Wyatte73/ME-507-Mecha06/README.md

# ME-507-Mecha16 Ice Cold Beer Project

## Documentation

[View the Doxygen documentation](https://wyatte73.github.io/ME-507-Mecha06/)

## Table of Contents
- [Project Overview](#projectoverview)
- [Major Hardware](#major-hardware)
  - [PCB](#pcb)
  - [Mechanical Design](#mechanical-design)
  - [Stepper Motors](#stepper-motors)
  - [Distance Sensor](#distance-sensor)
  - [LCD](#lcd)
  - [Switches](#switches)
  - [Limit Switches](#limit-switches)
- [Software](#software)
  - [Main](#main)
  - [LCD Driver](#lcd-driver)
- [Problems and Solutions](#problems-and-solutions)
- [Moving Forward](#moving-forward)

## Project Overview
[Back to top](#Table-of-Contents)

This repository contains the ME-507 term project by Wyatt Eberhart and Max Soury. The goal of the project was to design, fabricate, and test a custom printed circuit board for an embedded control system based on the STM32F411CE6U microcontroller.

The project was inspired by the classic Ice Cold Beer arcade game, where the player controls a bar to guide a ball upward while avoiding holes. In this version, the system uses two stepper motors to control the motion of the bar, allowing the user to adjust each side independently. A distance sensor, two limit switches, two user switches, and an LCD display were integrated into the system to allow for a control system and a user controlled mode.

The custom PCB served as the central hardware interface for the project. It connected the STM32 microcontroller to the motors, sensors, switches, and display, creating a clean and viable control platform. The STM32 reads the user switches and sensor inputs, processes the game-control logic, and commands the stepper motors to move the bar accordingly.

Overall, this project demonstrates the development of a complete embedded mechatronic system, combining PCB design, microcontroller programming, stepper motor control, sensor integration, and a user-interface to recreate a game. Figure 1 shows the game being replicated.

<p align="center">
  R
</p>
<p align="center">
  Figure 1. Ice Cold Beer Game
</p>

## Major Hardware
[Back to top](#Table-of-Contents)

### PCB

The PCB was based on the STM32 Blackpill, with additional features added to support motor control, display adjustment, and power regulation. The Blackpill reference design provided the basic circuitry required to operate the STM32F411CEU6, including reset, BOOT0, and Serial Wire Debugging connections. The PCB schematic is shown in Figure 2-3. The final PCB is shown in Figure 4 and the necessary components are shown in Figure 5.

Additional components were added to expand the board’s functionality. An 8 MHz crystal was included to provide more precise timing for the microcontroller. An LCD potentiometer was added to allow manual adjustment of the LCD brightness. For stepper motor control, two TMC2209 motor drivers and two TMC4210 motor controllers were included. The crystal is shown in Figure 5.

The TMC2209 motor drivers were used to drive the stepper motors. These ICs receive step and direction logic signals and generate the appropriate output signals for the motor coils. The step and direction signals are generated by the TMC4210 motor controllers, which communicate with the STM32 microcontroller over SPI. The TMC4210 uses motion parameters such as position, velocity, acceleration, and operating mode to generate the required step and direction outputs for each motor. The motor controllers and motor drivers are shown in Figure 6-7. 

The board was powered using a 12 V wall adapter. A buck converter, the LM2576, stepped the input voltage down from 12 V to 5 V, creating the 5 V power rail. An AMS1117 low-dropout linear regulator then reduced the 5 V rail to 3.3 V, which was used to power the STM32 microcontroller and other 3.3 V components. The power management system also included reverse-current protection to prevent current from flowing back into the wall adapter. The power system is shown in Figure 8-9.

<p align="center">
  
  
</p>
<p align="center">
  Figure 2-3. PCB Schematic
</p>

<p align="center">
  <img width="3024" height="4032"" alt="IMG_7492" src="https://github.com/user-attachments/assets/e71a02a3-5c6f-4b3f-9c1d-4fd526b5dee1" />
</p>
<p align="center">
  Figure 4. Final PCB
</p>
<p align="center">
  
</p>
<p align="center">
  Figure 5. Necessary components for the STM32
</p>
<p align="center">
  
</p>
<p align="center">
  Figure 6. Stepper motor controller and drivers
</p>
<p align="center">
 
</p>
<p align="center">
  Figure 7. Destroyed motor controller and alterned power input for motor controller
</p>
<p align="center">
  IMG_7495 (1)
</p>
<p align="center">
  Figure 8. Power management system
</p>
<p align="center">
 
</p>
<p align="center">
  Figure 9. LDO fix to remove thermal heat
</p>

### Mechanical Design
[Back to top](#Table-of-Contents)

The mechanical design uses two independently controlled lift assemblies located on opposite sides of the game board. This design works similarly to the mechanism used in the Ice Cold Beer arcade game, where each side of the support bar can move up and down independently to control the tilt of the playing surface or guide mechanism.

Each side of the mechanism is driven by a stepper motor connected to a lead screw. As the stepper motor rotates the lead screw, a lead screw nut converts the rotational motion into linear motion, causing the carriage to move vertically. This allows each side of the board mechanism to be raised or lowered independently.

Guide rods are used to constrain the carriage so that it moves only in the vertical direction. These rods prevent the carriage from twisting or rotating as the lead screw turns. The center rod is supported in a way that allows it to rotate freely while still maintaining proper alignment. One end of the rod is fixed axially and only allowed to rotate, while the opposite end is allowed to both rotate and slide. This prevents the assembly from being over-constrained and helps account for small alignment errors during motion.

Overall, the system uses two stepper-driven lead screw assemblies to control the vertical position of each side of the mechanism. By moving the two sides independently, the system can adjust the angle of the board or guide bar, allowing controlled movement of the ball during gameplay.

The other components are static and to structurally hold the assembly together. A CAD model of the system is shown in Figure 10. The overall system is shown in Figure 11. The lift assembly and sliding are shown in Figure 12. The fixed joint that holds the linear sensor is shown in Figure 13. 

<p align="center">

</p>
<p align="center">
  Figure 10. CAD model of the system
</p>
<p align="center">
 
</p>
<p align="center">
  Figure 11. Physical system
</p>
<p align="center">

</p>
<p align="center">
  Figure 12. Lift assembly and sliding joint
</p>
<p align="center">
  
</p>
<p align="center">
  Figure 13. Fixed joint with the linear sensor
</p>

### Stepper Motors
[Back to top](#Table-of-Contents)

The system uses 42BYGHM809 stepper motors to drive the vertical motion assemblies on each side of the game board. These motors were selected because they provide precise position control, which is necessary for accurately raising and lowering each side of the mechanism. These steppers have 400 steps/rev which allowed for greater precision and smoother rotation (less notchy). The stepper motor is shown in Figure 14.

<p align="center">
  
</p>
<p align="center">
  Figure 14. Stepper motor
</p>

### Distance Sensor
[Back to top](#Table-of-Contents)

A Pololu Distance Sensor V2 with pulse width output and a maximum sensing range of 50 cm, item 5562, was used to measure the position of the ball on the game board. The sensor outputs a pulse width signal that corresponds to the measured distance, allowing the microcontroller to determine how far the ball is from the sensor. This distance measurement can then be used as feedback for tracking the ball’s position during gameplay. The distance sensor is shown in Figure 15.

<p align="center">
  
</p>
<p align="center">
  Figure 15. Distance sensor
</p>

### LCD
[Back to top](#Table-of-Contents)

A generic LCD module was added for user information. Either to display the current estimated position of the ball, in control mode. Or to display a time for scorekeeping in the user control mode. The LCD is driven by an on board controller that uses the Hitachi LCD interfacing protocol. Because of an abundacne of MCU GPIO ports the LCD was driven directly using the 11 pin control scheme, and a shift register was not included for simplicity. The LCD is shown in FIgure 16.

<p align="center">
  
</p>
<p align="center">
  Figure 16. LCD
</p>

### Switches
[Back to top](#Table-of-Contents)

Rocker switches were used as user input controls for the system. These switches provide a simple and reliable way for the user to control the motors up or down. Since they are single-pole double-throw switches, each switch can route a signal between two different states or positions.

<p align="center">
  
</p>
<p align="center">
  Figure 17. Rocker switch
</p>

### Limit Switches
[Back to top](#Table-of-Contents)

Limit switches were used to detect the end positions of the moving carriages. These switches help prevent the mechanism from traveling beyond its intended range. When a carriage reaches a limit switch, the switch sends a signal to the TMS4210 motor controller. This allows the software to stop or home the motor, protecting the mechanical system from overtravel or damage. The limit switch is shown in Figure 18.

<p align="center">
  
</p>
<p align="center">
  Figure 18. Limit switch 
</p>

## Software
[Back to top](#Table-of-Contents)

### Main

This holds the initialization code for the motor controllers and handles the distance sensor readings via an interupt on the timer channel it is connected to. This interupt function tracks the amount of clock ticks between the high and low pulses from the disance sensor's pwm output and then converts it to a distance in inches based on a linear curve fit. It then displays this distance data on the LCD screen, updated less frequently than the actual distance value.

### LCD Driver
[Back to top](#Table-of-Contents)

This library takes the basic commands of the Hitachi protocol LCD driver and allows the display to be cleared, the location of the cursor moved, or to write a single ascii character to the display. This library ensures the lcd has had enough time to update before sending commands, and due to limitations discussed later only sends write commands to the board.

### Problems and Solutions
[Back to top](#Table-of-Contents)

On the power side of the board, there were a few surpassable issues. Firstly, the thermal pin on the LDO to move from 5V to 3V3 is wired to ground on the board and internally connected to the output. The capacitor attached to the output of the switching regulator was designed around a size of capacitor that does not come in the intended package. And the diode connected to the reverse current protection circut did not have through holes large enough to mount properly.

All of these problems were able to be worked around. After destroying a handfull of regulators the source of the problem was found and the chip was stood up such that the thermal pin was floating and some extra wire was added to act as a heatsink. Some jumper wires were added to the pads designated for the mis-sized capacitor and the capacitor was added to these wires. And the leads for the diode were clipped to a reasonable length and soldered on top of the though holes. The power side of the board remained stable after these changes.

The LCD had a few problems that needed fixing. The enable pin and the contrast voltage pin were both pulled to 5V which caused the board to not be able to recieve commands, but also for the characters on the screen to not be visible. This was solved by sacrificing the R/W pin on the connector and transforming it into the enable pin, this tied the R/W signal to ground and removed the ablilty to read from our display but allowed for commands in general to be sent. And to fix the contrast issue a resistor was added to the contrast voltage pin, normally a potentiometer is added in this place to fine tune the contrast on the display but as this was a hot fix the ability to ajust contrast was forgone and manually set to an accpetable level.

The largest problems came unfortunately in the most important part of out design, being our motors, The main problem was the chips were designed in 5V operating mode, while the MCU uses 3V3 logic. This caused some issues with SPI communication so pins on the motoin control chips were bent and ajusted to work on 3V3 by tying them to the test points on the board. This sucessfully enabled communication with the chips and allowed for velocites to be sent to the stepper motors. 

A much larger setback was during testing and diagnosis of the logic voltage issue, one of the motion controllers was removed from the board to simplify testing, however its matching motor driver was left on the board and, lacking the current regulation from the controller, was catastrophically destroyed under the amperage of the power supply. This was an unrecoverable event and is the reason most of the functionallity of our system is not present. 

The pivoted idea was to just have the distance sensor controll the motor in 1D and balance the ball in the center of the shaft, but during implementation the second motor controller stopped responding. So in its current state the device reads a distace value and displays it on the LCD.

### Moving Forward
[Back to top](#Table-of-Contents)

We Both are very sadened to have this be the outcome of the project, but we both feel extremely confidant in a V2 of the system if were to have permitted it. It is almost certian that a second version of the PCB would still not be perfect, but with our newfound understanding it would be a significant improvment on the first rendition, and would have allowed us to begin to tackle the chalenge of controling the system. Becides the re-assigning of pins and resizing of components, a more more enlightened outlook would be taken when selecting the motor control and driving ICs and could be swapped to a DC motor and encoder setup to simplify the control hardware, while increasing the software load.
