Wyatte73/ME-507-Mecha06/ICB/Core/Src/main.c

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
/* Includes ------------------------------------------------------------------*/
#include "main.h"

/* USER CODE BEGIN Includes */
#include "LCD.h"
#include <math.h>
#include <stdio.h>
/* USER CODE END Includes */

SPI_HandleTypeDef hspi2;

TIM_HandleTypeDef htim2;
TIM_HandleTypeDef htim4;

/* USER CODE BEGIN PV */
uint8_t en_sd[4] = {0x34, 0x00, 0x00, 0x01};
uint8_t V_MIN[4]    = {0b00000100, 0b00000000, 0b00000000, 0b00000100};
uint8_t V_MAX[4]    = {0b00000110, 0b00000000, 0b00000000, 0b10000000};
uint8_t PR_DIV[4]   = {0b00011000, 0b00000000, 0b00100010, 0b00000000};
uint8_t A_MAX[4]    = {0b00001100, 0b00000000, 0b00000000, 0b00100000};
uint8_t V_TAR[4] = {0b00001000,0b00000000,0b00000000,0b00100000};
uint8_t ref_con[4] = {0b00010100,0b00000000,0b00000011,0b00000010};

// +128
uint8_t V_TARU_1[2] = {0b00001000, 0b00000000};
uint8_t V_TARU_2[2] = {0b00000000, 0b10000000};

// -128
uint8_t V_TARD_1[2] = {0b00001000, 0b00000000};
uint8_t V_TARD_2[2] = {0b00001111, 0b10000000};


uint8_t V_ACT_1[4] = {0b00001001,0b00000000,0b00000000,0b00000000};
uint8_t V_ACT_R[4];

uint8_t V_old;
uint8_t count = 0;

uint8_t dir = 0;

LCD_param_t LCD = {RS_GPIO_Port,RS_Pin,EN_GPIO_Port,EN_Pin,RW_GPIO_Port,RW_Pin,DB0_GPIO_Port,DB0_Pin,
		DB1_GPIO_Port,DB1_Pin,DB2_GPIO_Port,DB2_Pin,DB3_GPIO_Port,DB3_Pin,DB4_GPIO_Port,DB4_Pin,
		DB5_GPIO_Port,DB5_Pin,DB6_GPIO_Port,DB6_Pin,DB7_GPIO_Port,DB7_Pin};

char digs[5];


uint8_t test;

uint32_t loop = 0;

volatile uint32_t val1 = 0;
volatile uint32_t val2 = 0;
volatile uint32_t pulse_width = 0;
volatile uint8_t is_rising_edge = 1;
float pulse_raw;

/* USER CODE END PV */

void SystemClock_Config(void);
static void MX_GPIO_Init(void);
static void MX_SPI2_Init(void);
static void MX_TIM4_Init(void);
static void MX_TIM2_Init(void);
/**
  * @brief  The application entry point.
  * @retval int
  */
int main(void)
{

  /* MCU Configuration--------------------------------------------------------*/

  /* Reset of all peripherals, Initializes the Flash interface and the Systick. */
  HAL_Init();

  /* Configure the system clock */
  SystemClock_Config();

  /* Initialize all configured peripherals */
  MX_GPIO_Init();
  MX_SPI2_Init();
  MX_TIM4_Init();
  MX_TIM2_Init();
  /* USER CODE BEGIN 2 */

  HAL_TIM_PWM_Start(&htim4, TIM_CHANNEL_4);



  /* Set V_MIN */
  HAL_GPIO_WritePin(nCs2_GPIO_Port,nCs2_Pin,GPIO_PIN_RESET);
  HAL_SPI_Transmit(&hspi2,V_MIN,4,1);
  HAL_GPIO_WritePin(nCs2_GPIO_Port,nCs2_Pin,GPIO_PIN_SET);

  /* Set V_MAX */
  HAL_GPIO_WritePin(nCs2_GPIO_Port,nCs2_Pin,GPIO_PIN_RESET);
  HAL_SPI_Transmit(&hspi2,V_MAX,4,1);
  HAL_GPIO_WritePin(nCs2_GPIO_Port,nCs2_Pin,GPIO_PIN_SET);

  /* Set PULSE_DIV / RAMP_DIV */
  HAL_GPIO_WritePin(nCs2_GPIO_Port,nCs2_Pin,GPIO_PIN_RESET);
  HAL_SPI_Transmit(&hspi2,PR_DIV,4,1);
  HAL_GPIO_WritePin(nCs2_GPIO_Port,nCs2_Pin,GPIO_PIN_SET);

  /* Set A_MAX */
  HAL_GPIO_WritePin(nCs2_GPIO_Port,nCs2_Pin,GPIO_PIN_RESET);
  HAL_SPI_Transmit(&hspi2,A_MAX,4,1);
  HAL_GPIO_WritePin(nCs2_GPIO_Port,nCs2_Pin,GPIO_PIN_SET);

  /* Set reference switch configuration and velocity mode */
  HAL_GPIO_WritePin(nCs2_GPIO_Port,nCs2_Pin,GPIO_PIN_RESET);
  HAL_SPI_Transmit(&hspi2,ref_con,4,1);
  HAL_GPIO_WritePin(nCs2_GPIO_Port,nCs2_Pin,GPIO_PIN_SET);

  /* Enable Step/Dir output */
  HAL_GPIO_WritePin(nCs2_GPIO_Port,nCs2_Pin,GPIO_PIN_RESET);
  HAL_SPI_Transmit(&hspi2,en_sd,4,1);
  HAL_GPIO_WritePin(nCs2_GPIO_Port,nCs2_Pin,GPIO_PIN_SET);

  /* Set V_TARGET */
  /*
  HAL_GPIO_WritePin(nCs2_GPIO_Port,nCs2_Pin,GPIO_PIN_RESET);
  HAL_SPI_Transmit(&hspi2,V_TAR_1,2,1);
  HAL_SPI_Transmit(&hspi2,V_TAR_2,2,1);
  HAL_GPIO_WritePin(nCs2_GPIO_Port,nCs2_Pin,GPIO_PIN_SET);
  */

HAL_GPIO_WritePin(RW_GPIO_Port,RW_Pin,GPIO_PIN_SET);


  Init(LCD);
  ClearDis(LCD);
  PutChar(LCD,'D');
  PutChar(LCD,'I');
  PutChar(LCD,'S');
  PutChar(LCD,'T');
  PutChar(LCD,'A');
  PutChar(LCD,'N');
  PutChar(LCD,'C');
  PutChar(LCD,'E');
  PutChar(LCD,':');
  PutChar(LCD,'0');
  PutChar(LCD,'0');
  PutChar(LCD,'.');
  PutChar(LCD,'0');
  PutChar(LCD,'0');
  PutChar(LCD,'i');
  PutChar(LCD,'n');
  while (count < 7) {ShiftCursor(LCD,'L'); count++;}
  count = 0;

  HAL_TIM_IC_Start_IT(&htim2, TIM_CHANNEL_1);
  /* USER CODE END 2 */

  /* Infinite loop */
  /* USER CODE BEGIN WHILE */
  while (1)
  {
	  pulse_raw = pulse_width * .0003 - 29;


	  int16_t velocity = (int16_t)(roundf(pulse_raw) * 10);
	  // Clamp to 12-bit signed range [-2047, 2047]
	  if (velocity >  2047) velocity =  2047;
	  if (velocity < -2047) velocity = -2047;

	  V_TAR[1] = 0x00;
	  V_TAR[2] = (velocity >> 8) & 0x0F;
	  V_TAR[3] = (uint8_t)(velocity & 0xFF);

	  if (V_TAR[3] != V_old){
	  HAL_GPIO_WritePin(nCs2_GPIO_Port,nCs2_Pin,GPIO_PIN_RESET);
	  HAL_SPI_Transmit(&hspi2,V_TAR,4,1);
	  HAL_GPIO_WritePin(nCs2_GPIO_Port,nCs2_Pin,GPIO_PIN_SET);
	  V_old = V_TAR[3];
	  }


	  if (loop % 10000 == 0){
		  test = (uint8_t)roundf(pulse_raw*100);
		  if(pulse_raw<1){
			  snprintf(digs,sizeof(digs),"%d",(int)roundf(pulse_raw * 100));
			  PutChar(LCD,'0');
			  PutChar(LCD,'0');
			  ShiftCursor(LCD,'R');
			  PutChar(LCD,digs[0]);
			  PutChar(LCD,digs[1]);
		  		  }
		  else if(pulse_raw<10){
		  	  snprintf(digs,sizeof(digs),"%d",(int)roundf(pulse_raw * 100));
		  	  PutChar(LCD,'0');
		  	  PutChar(LCD,digs[0]);
		  	  ShiftCursor(LCD,'R');
		  	  PutChar(LCD,digs[1]);
		  	  PutChar(LCD,digs[2]);
		  }

		  else{
			  snprintf(digs,5,"%d",(int)roundf(pulse_raw * 100));
			  PutChar(LCD,digs[0]);
			  PutChar(LCD,digs[1]);
			  ShiftCursor(LCD,'R');
			  PutChar(LCD,digs[2]);
			  PutChar(LCD,digs[3]);
		  }
		  	  while (count < 5) {ShiftCursor(LCD,'L'); count++;}
		  	  count=0;
	  }
	  loop++;

    /* USER CODE END WHILE */

    /* USER CODE BEGIN 3 */
  }
  /* USER CODE END 3 */
}

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
/* USER CODE BEGIN 4 */

void HAL_TIM_IC_CaptureCallback(TIM_HandleTypeDef *htim)
{
    if (htim->Instance != TIM2) return;  // Guard: only handle TIM2

    if (is_rising_edge) {
        // Capture rising edge timestamp
        val1 = HAL_TIM_ReadCapturedValue(htim, TIM_CHANNEL_1);

        // Switch to falling edge
        __HAL_TIM_SET_CAPTUREPOLARITY(htim, TIM_CHANNEL_1,
                                      TIM_INPUTCHANNELPOLARITY_FALLING);
        is_rising_edge = 0;

    } else {
        // Capture falling edge timestamp
        val2 = HAL_TIM_ReadCapturedValue(htim, TIM_CHANNEL_1);

        // Handle 32-bit timer overflow correctly
        if (val2 >= val1) {
            pulse_width = val2 - val1;
        } else {
            pulse_width = (0xFFFFFFFF - val1) + val2 + 1;
        }

        // Switch back to rising edge for next pulse
        __HAL_TIM_SET_CAPTUREPOLARITY(htim, TIM_CHANNEL_1,
                                      TIM_INPUTCHANNELPOLARITY_RISING);
        is_rising_edge = 1;
    }
}

/* USER CODE END 4 */
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
