Wyatte73/ME-507-Mecha06/ICB/Core/Inc/main.h

#define OUT_Pin GPIO_PIN_0
#define OUT_GPIO_Port GPIOA
#define RS_Pin GPIO_PIN_1
#define RS_GPIO_Port GPIOA
#define RW_Pin GPIO_PIN_2
#define RW_GPIO_Port GPIOA
#define DB0_Pin GPIO_PIN_3
#define DB0_GPIO_Port GPIOA
#define DB1_Pin GPIO_PIN_4
#define DB1_GPIO_Port GPIOA
#define DB2_Pin GPIO_PIN_5
#define DB2_GPIO_Port GPIOA
#define DB3_Pin GPIO_PIN_6
#define DB3_GPIO_Port GPIOA
#define DB4_Pin GPIO_PIN_7
#define DB4_GPIO_Port GPIOA
#define DB5_Pin GPIO_PIN_0
#define DB5_GPIO_Port GPIOB
#define DB6_Pin GPIO_PIN_1
#define DB6_GPIO_Port GPIOB
#define DB7_Pin GPIO_PIN_2
#define DB7_GPIO_Port GPIOB
#define EN_Pin GPIO_PIN_12
#define EN_GPIO_Port GPIOB
#define nCs2_Pin GPIO_PIN_13
#define nCs2_GPIO_Port GPIOB
#define LED_Pin GPIO_PIN_8
#define LED_GPIO_Port GPIOA
#define DN2_Pin GPIO_PIN_4
#define DN2_GPIO_Port GPIOB
#define UP2_Pin GPIO_PIN_5
#define UP2_GPIO_Port GPIOB
#define DN1_Pin GPIO_PIN_6
#define DN1_GPIO_Port GPIOB
#define UP1_Pin GPIO_PIN_7
#define UP1_GPIO_Port GPIOB
