Wyatte73/ME-507-Mecha06/(commit log)

2026-06-11 Update PCB images and figure references in README
2026-06-11 Enhance README with additional figures and descriptions
    Added figures to illustrate PCB schematic, final PCB, necessary components, motor controller, and power management system.
